RoryFleming/CRT-420-Fleming/README.md

# CRT 420 Fleming
This is a good read. Read: 1/17/18
