RoryFleming/CRT-420-Fleming/Documentation/07 Function Production.pdf

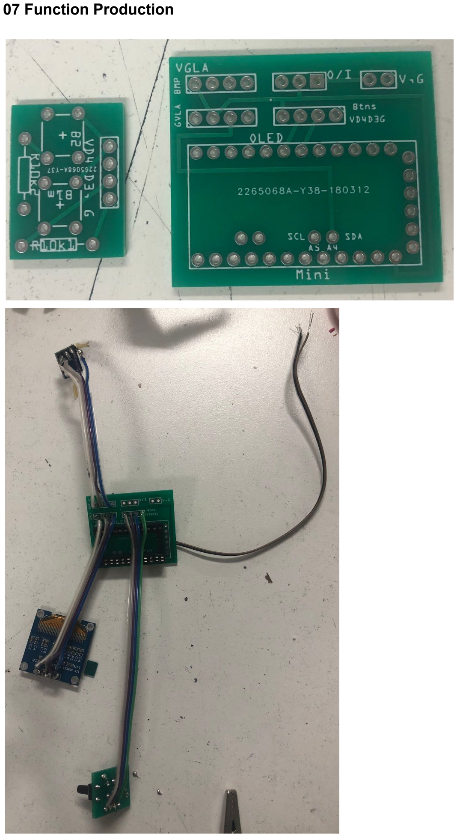
[picture p20: page 1]

### 07 Function Production

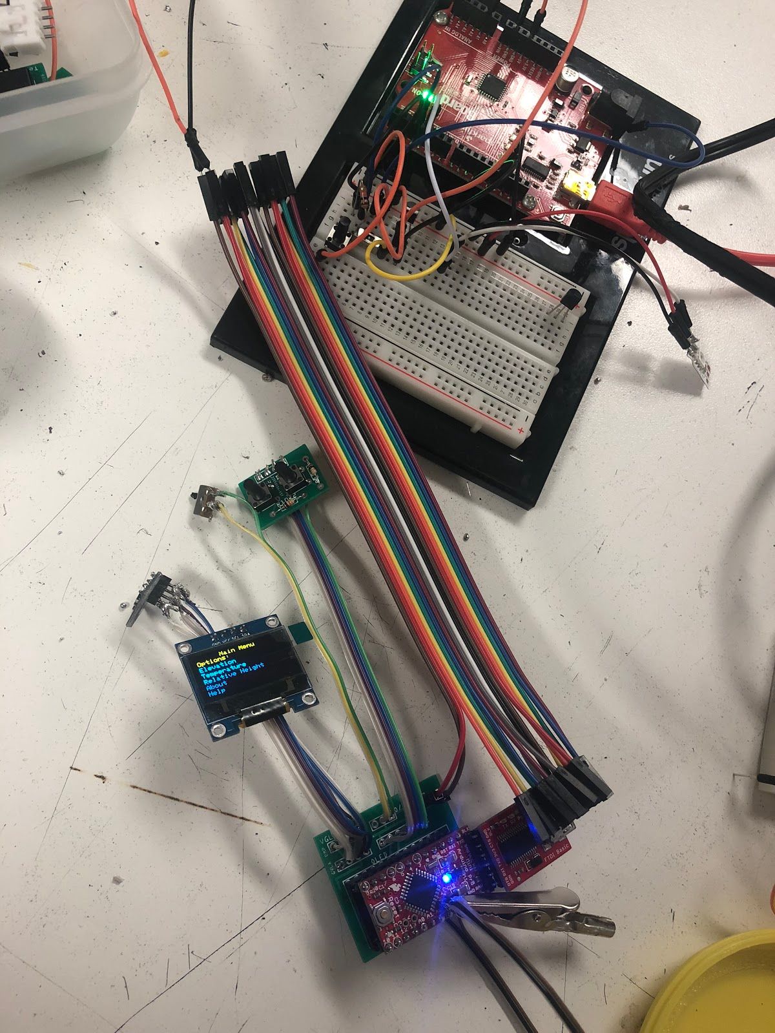
[picture p21: figure]

All parts soldered together and functioning: Buttons, barometer, OLED, O/I switch

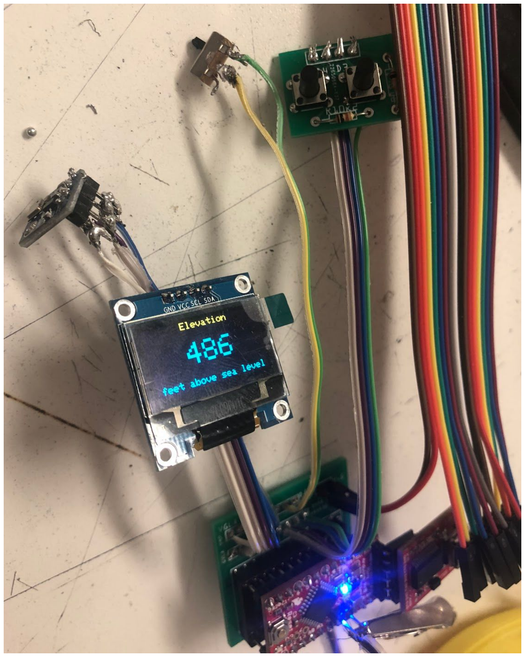
[picture p22: figure]

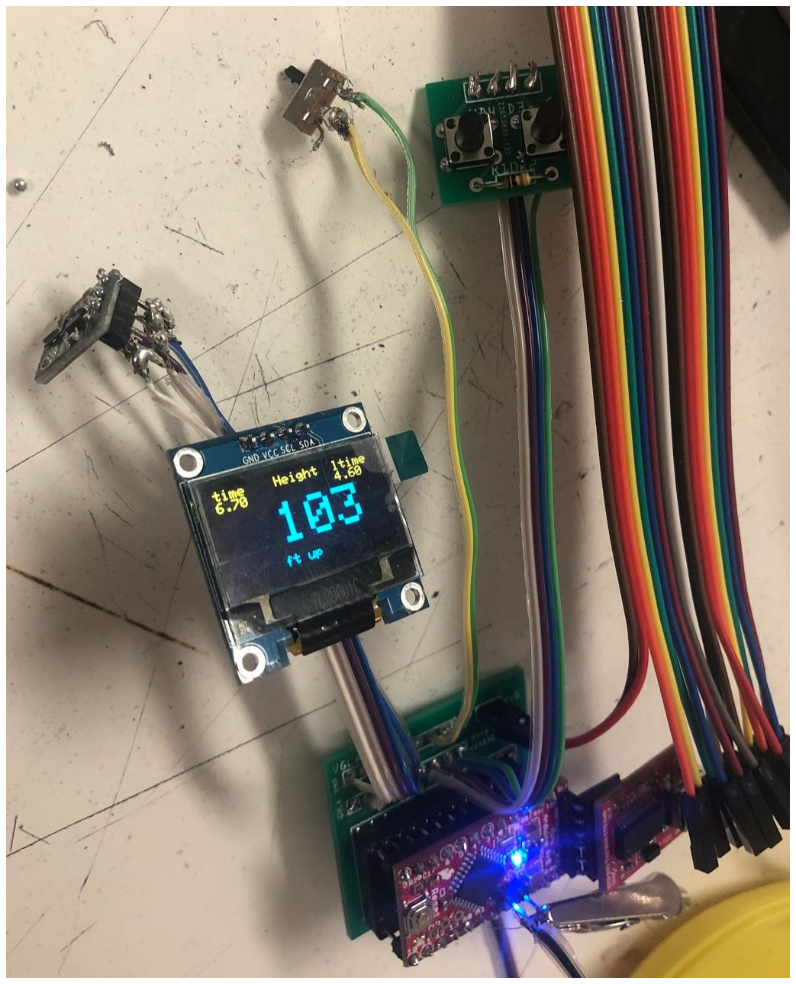
[picture p23: figure]
