RoryFleming/CRT-420-Fleming/Documentation/08 Form Production.pdf

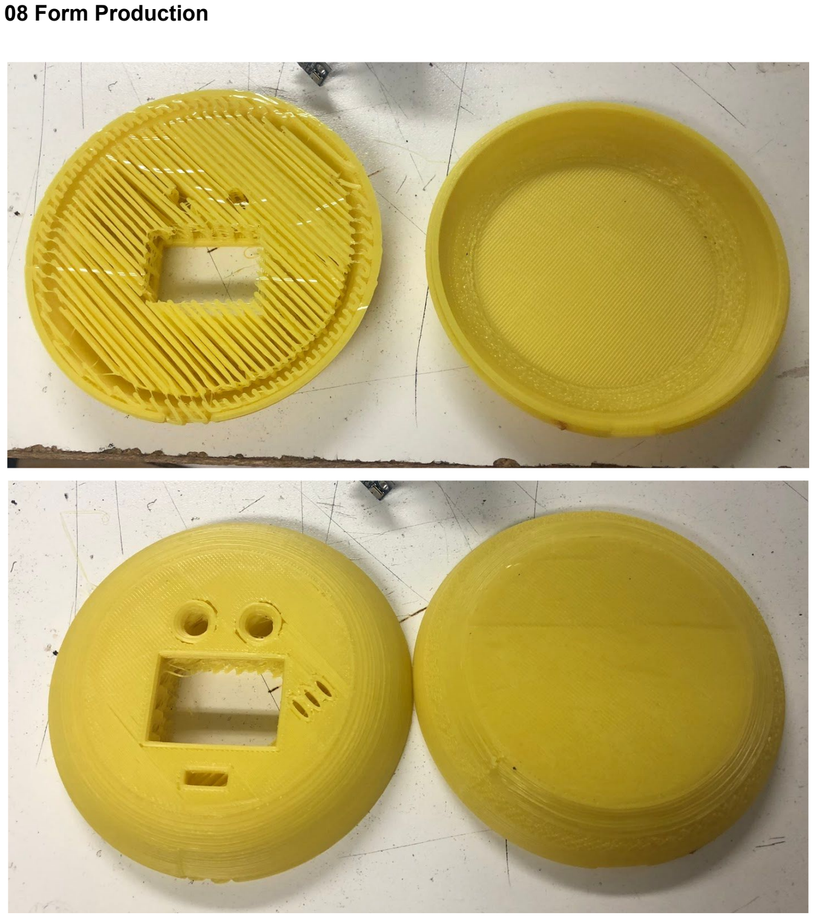
[picture p24: page 1]

### 08 Form Production

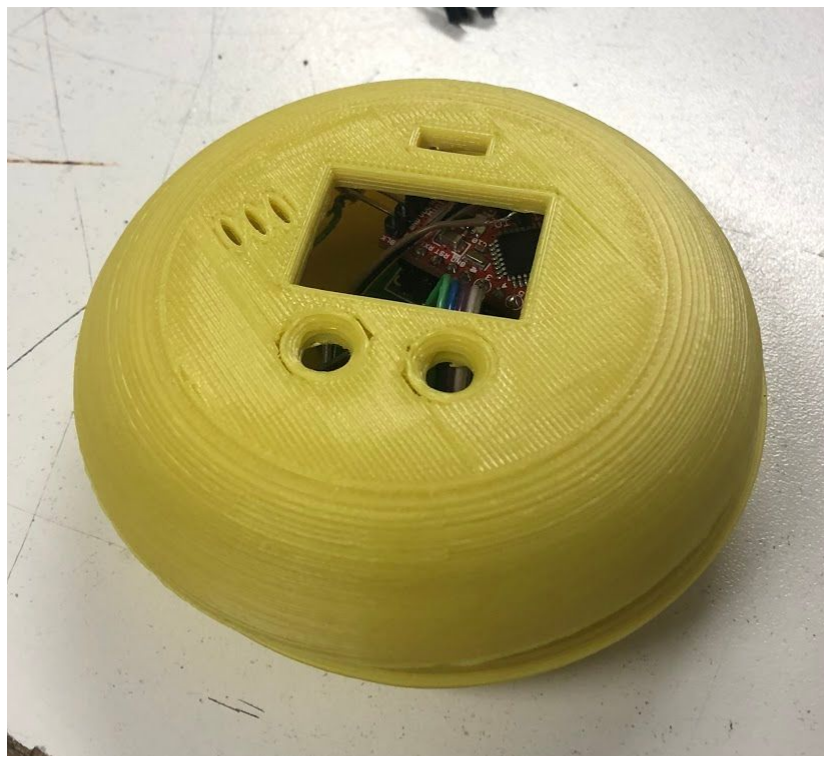
[picture p25: figure]

(Some changes had to be made from here: button holes too far apart for buttons fixed on PCB to fit, O/l switch doesn’t fit through hole, header pins on OLED push against casing too much on inside.)
Some extra printed plastic on top half inner lip prevented complete sealing.

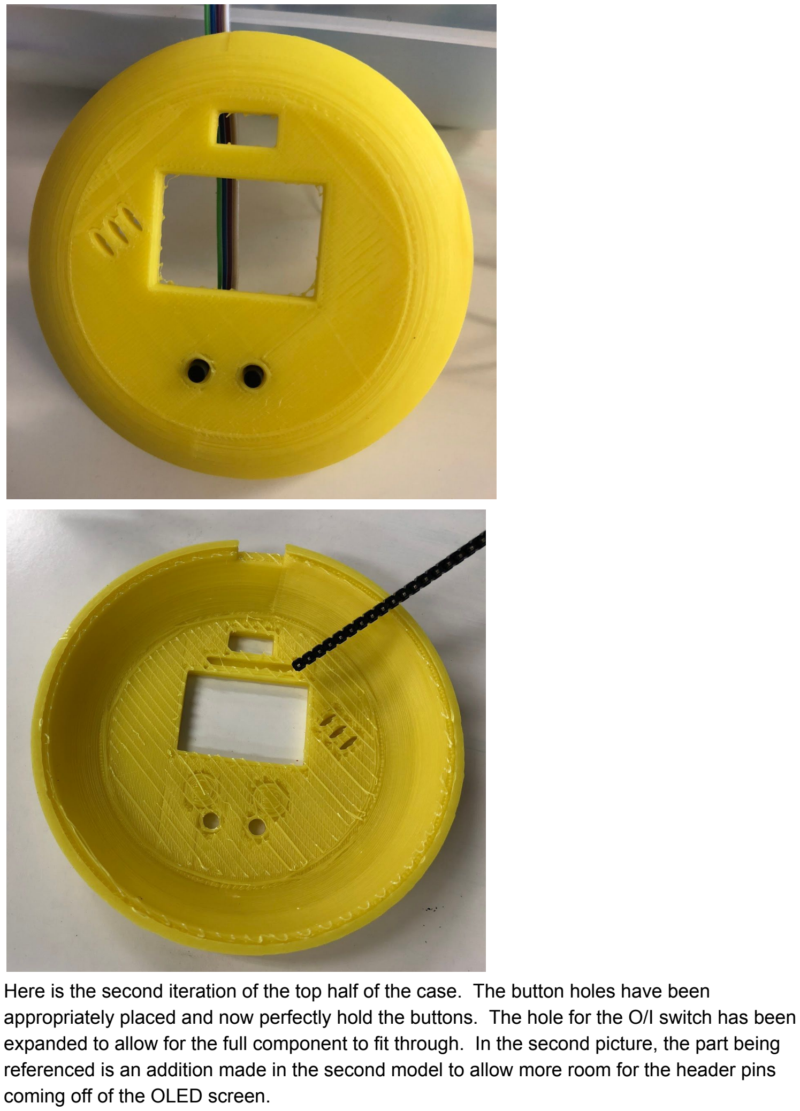
[picture p26: page 3]

Here is the second iteration of the top half of the case. The button holes have been appropriately placed and now perfectly hold the buttons. The hole for the O/I switch has been expanded to allow for the full component to fit through. In the second picture, the part being referenced is an addition made in the second model to allow more room for the header pins coming off of the OLED screen.

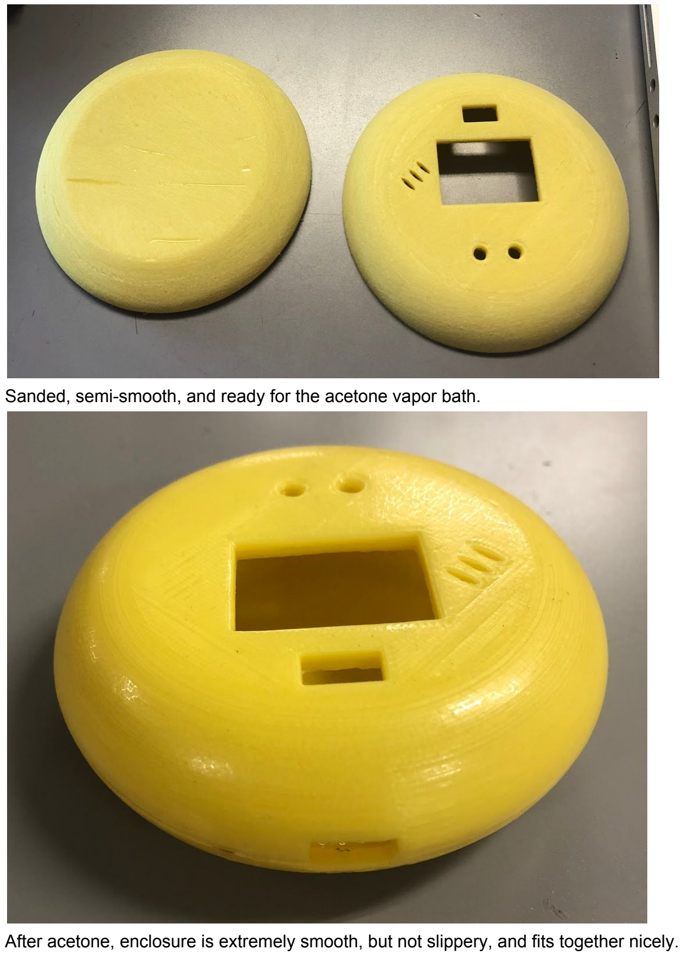
[picture p27: page 4]

Sanded, semi-smooth, and ready for the acetone vapor bath.

After acetone, enclosure is extremely smooth, but not slippery, and fits together nicely.

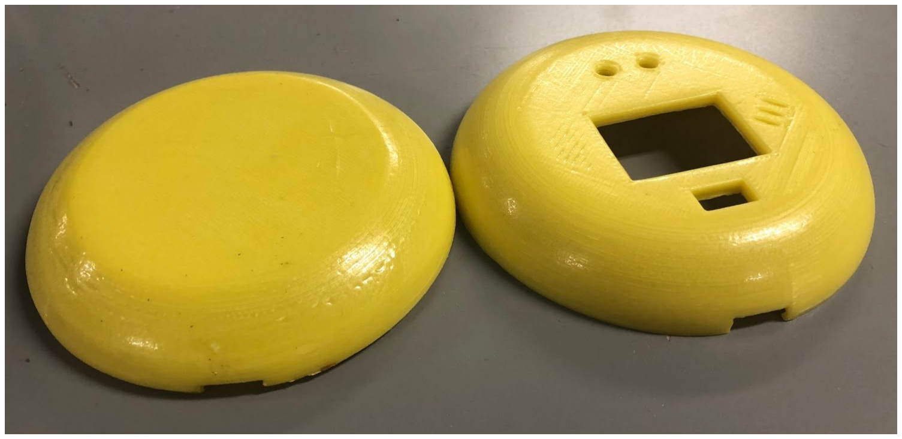
[picture p28: figure]

No extra parts needed for case, although connecting components inside is a different story.
