RoryFleming/CRT-420-Fleming/Documentation/04 Function Development.pdf

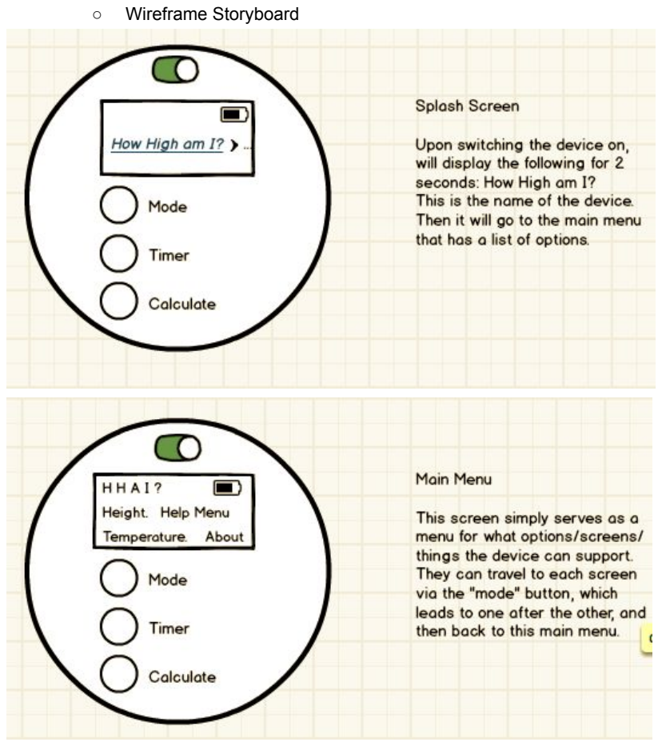
[picture p33: page 1]

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
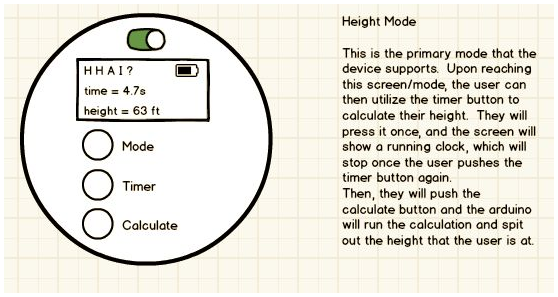
[picture p34: figure]
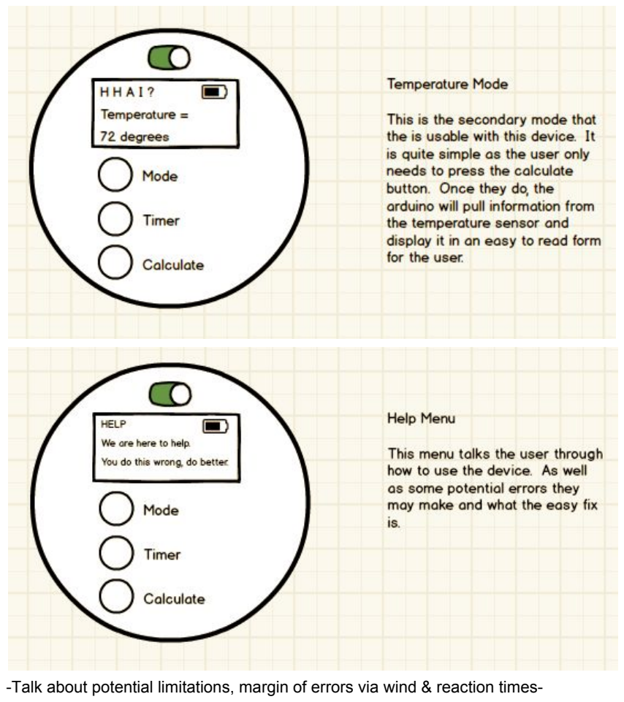
[picture p35: page 3]

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
tial limit

a

tio

n

s, m

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
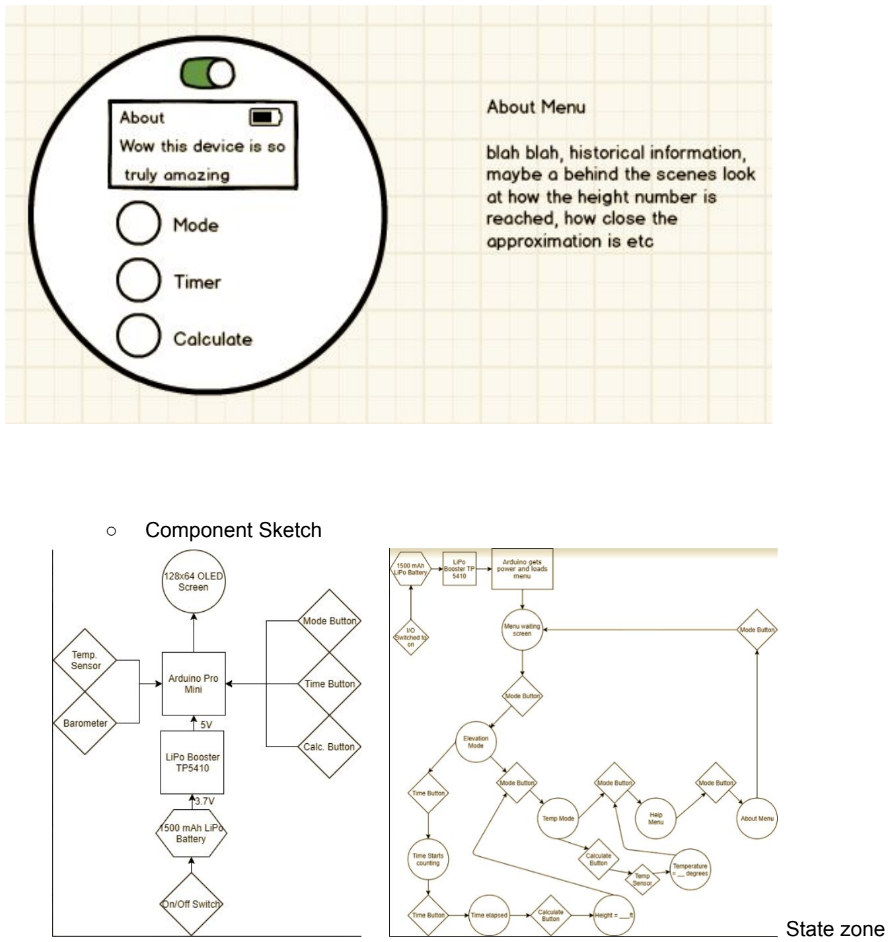
[picture p36: page 4]

- Component Sketch

State zone

- Bill of Materials -
Name | Source | URL | Qty. | Cost
Arduino Pro Mini | AliExpress | https://goo.gl/XTJmMD | 1 | $2.40
OLED Screen 128x64 | Amazon | https://goo.gl/cAiPSX | 1 | $8.99
500 mAh LiPo Bat. | Amazon | https://goo.gl/6sKL4H | 1 | $7.99
LiPo Booster TP5410 | Ebay | https://goo.gl/nNtNMM | 1 | $2.19
10k Ohm Resistor | Lab | | 3 | $2
Push Buttons | Lab | | 3 | $2
Power Slide Switch | Lab | | 1 | $1
Barometer BMP180 | MakerAdvisor | https://goo.gl/riw4MG | 1 | $2

Total cost: $_28.57_
References:

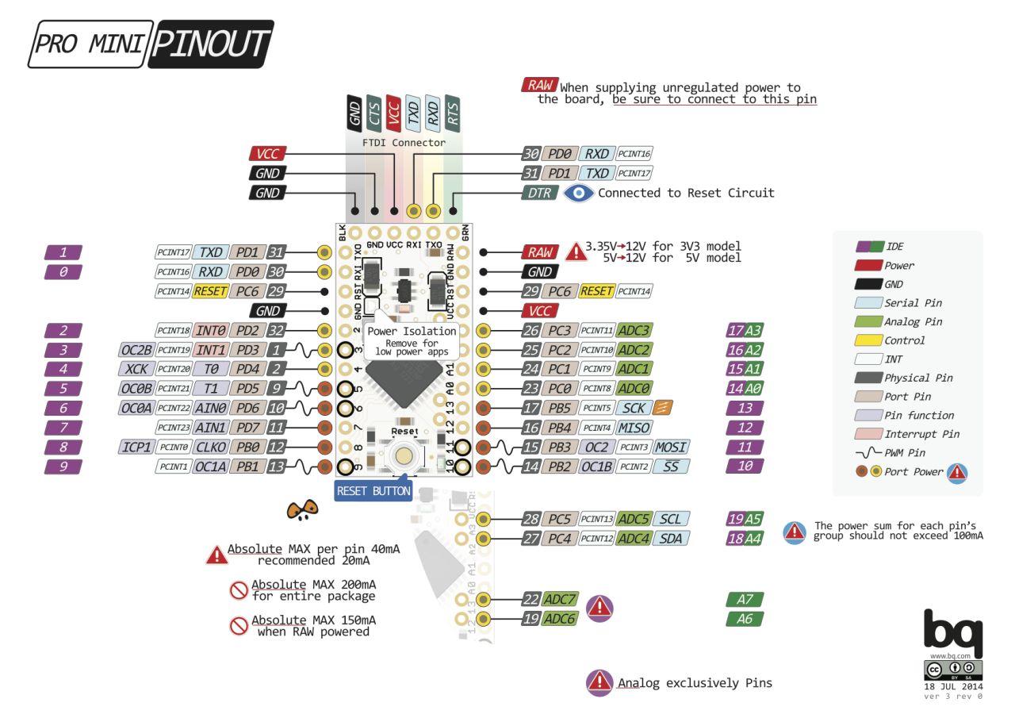
[picture p37: figure]

LED Screen: https://www.youtube.com/watch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 LiPo Battery: https://goo.gl/6sKL4H
LiPo Booster: https://www.youtube.com/watch?v=aND0j2Y2IkM
Buttons: https://learn.sparkfun.com/tutorials/switch-basics
Temp Sensor: https://learn.adafruit.com/tmp36-temperature-sensor/using-a-temp-sensor Barometer: https://learn.sparkfun.com/tutorials/bmp180-barometric-pressure-sensor-hookup-

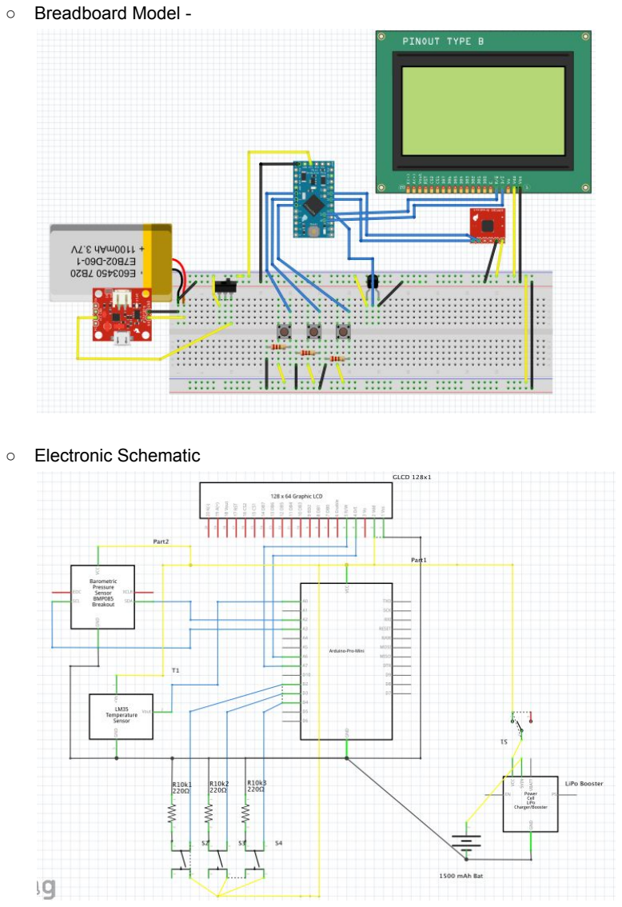
[picture p38: page 6]

- Breadboard Model -
- Electronic Schematic
