RoryFleming/CRT-420-Fleming/Documentation/05 Function Proof.pdf

### 05 Function Proof

Functional Breadboard-

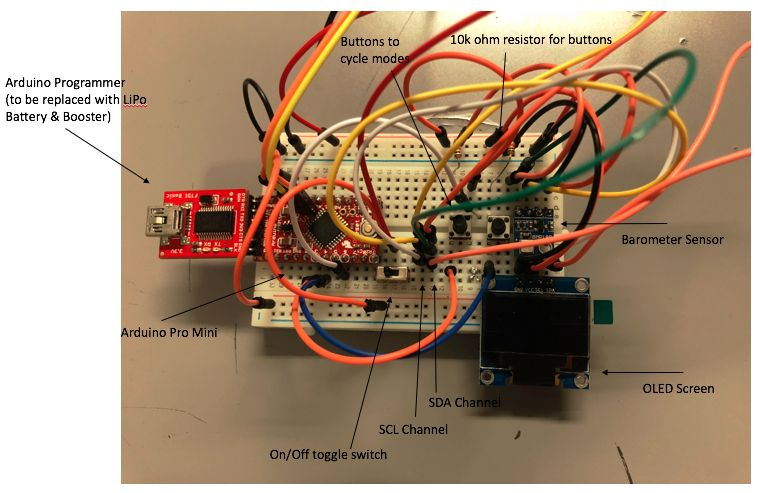
[picture p39: figure]

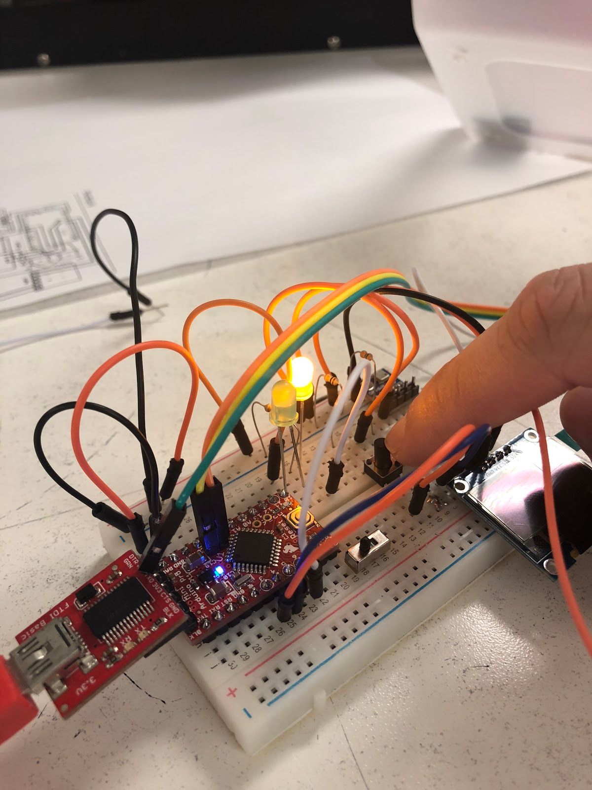
[picture p40: figure]

Buttons work properly. Not pictured: slide switch controlling power correctly

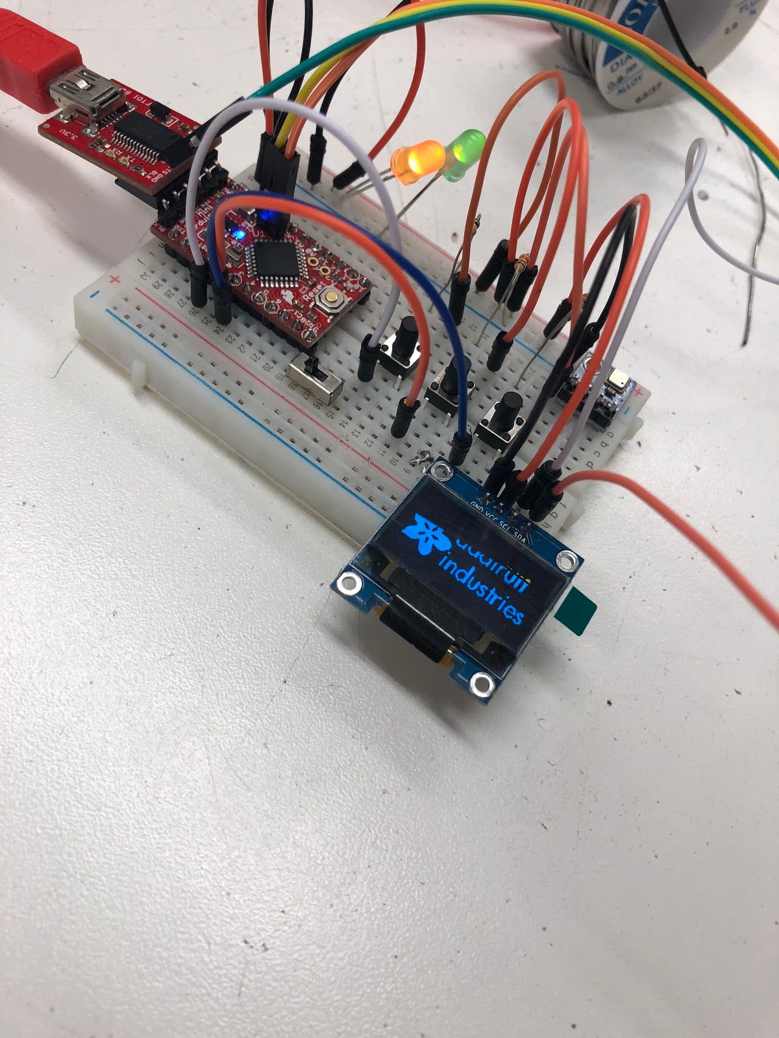
[picture p41: page 3]

Screen loads startup menu

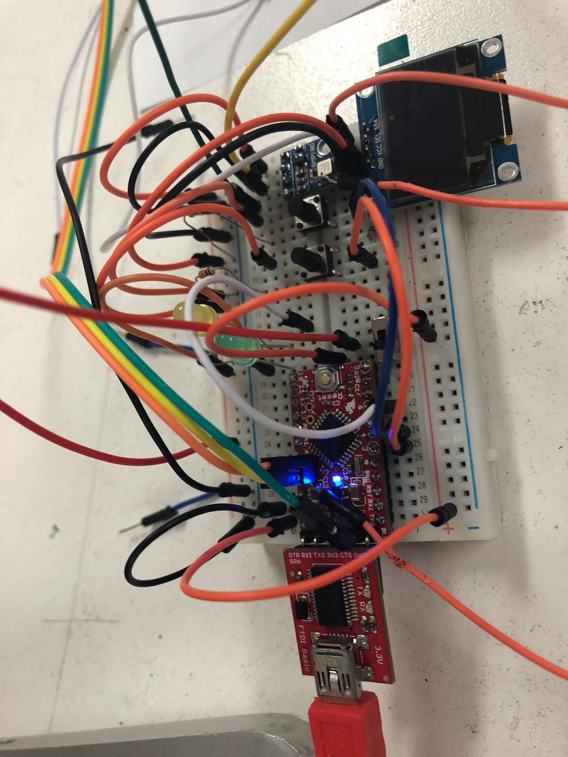
[picture p42: figure]

Barometer is connected to SLC & SDA, rather than the OLED in this photo

Libraries for Barometer:
#include <SFE_BMP180.h>

#include <Wire.h>

Example code for barometer:
File / Examples / Sparkfun BMP180 / SFE_BMP180_example //for BMP180

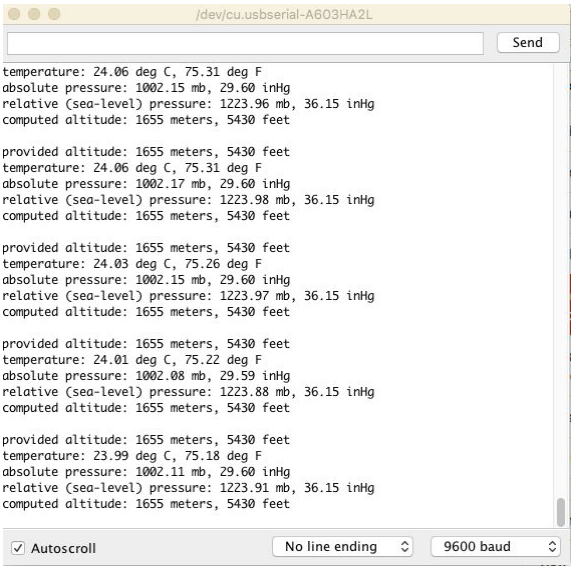
[picture p43: figure]

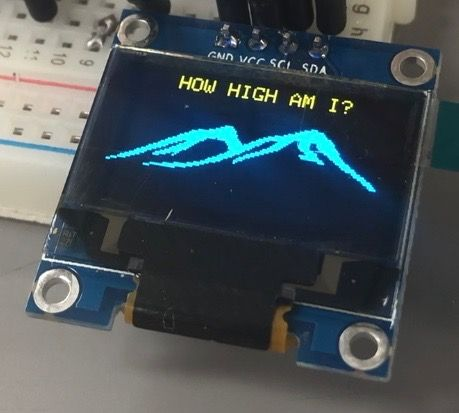
[picture p44: figure]

Splash Screen appears for 3 seconds upon starting program

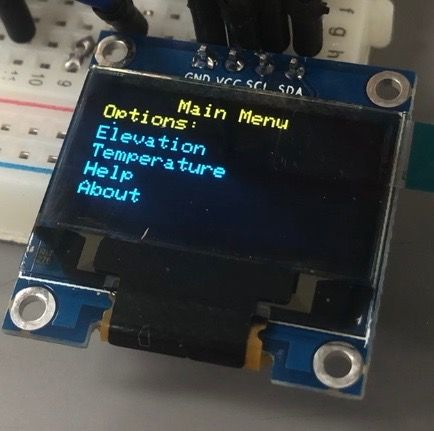
[picture p45: figure]

Main menu showing available options on device, “mode” button cycles through these pages

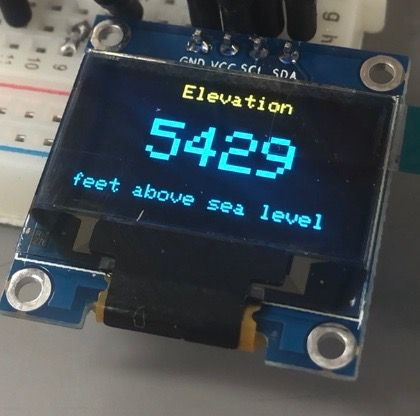
[picture p46: figure]

Showing standard elevation, code based in Colorado

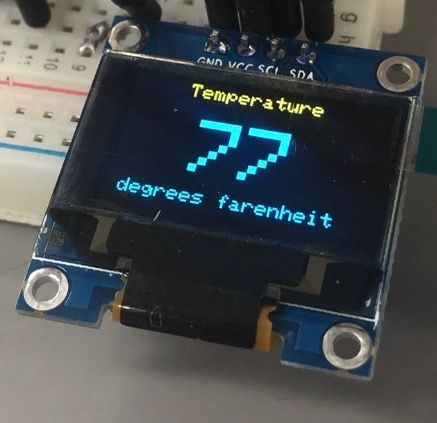
[picture p47: figure]

Elevation and temperature both functioning & drawing from barometer properly

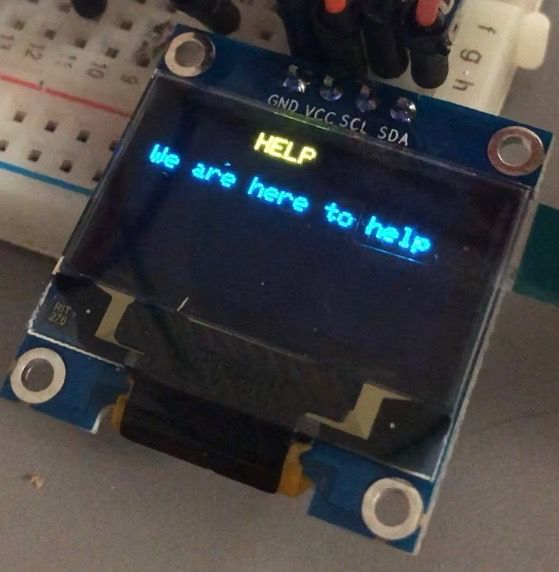
[picture p48: figure]

Help Screen

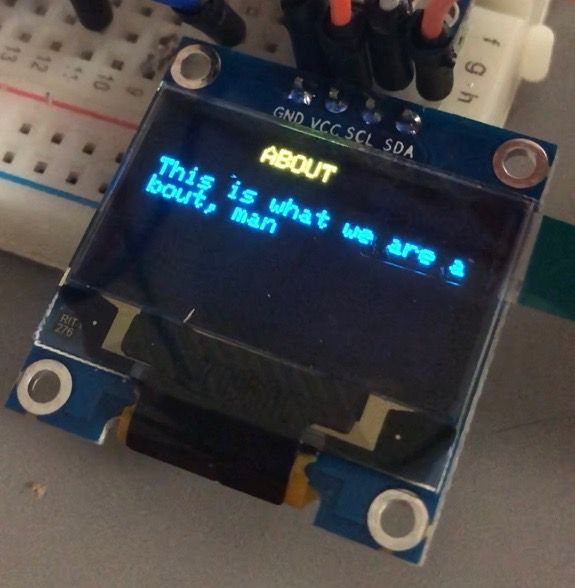
[picture p49: figure]

Initial About page

LED Screen: https://www.youtube.com/watch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 LiPo Booster: https://www.youtube.com/watch?v=aND0j2Y2IkM
Buttons: https://learn.sparkfun.com/tutorials/switch-basics
Barometer: https://learn.sparkfun.com/tutorials/bmp180-barometric-pressure-sensor-hookup-

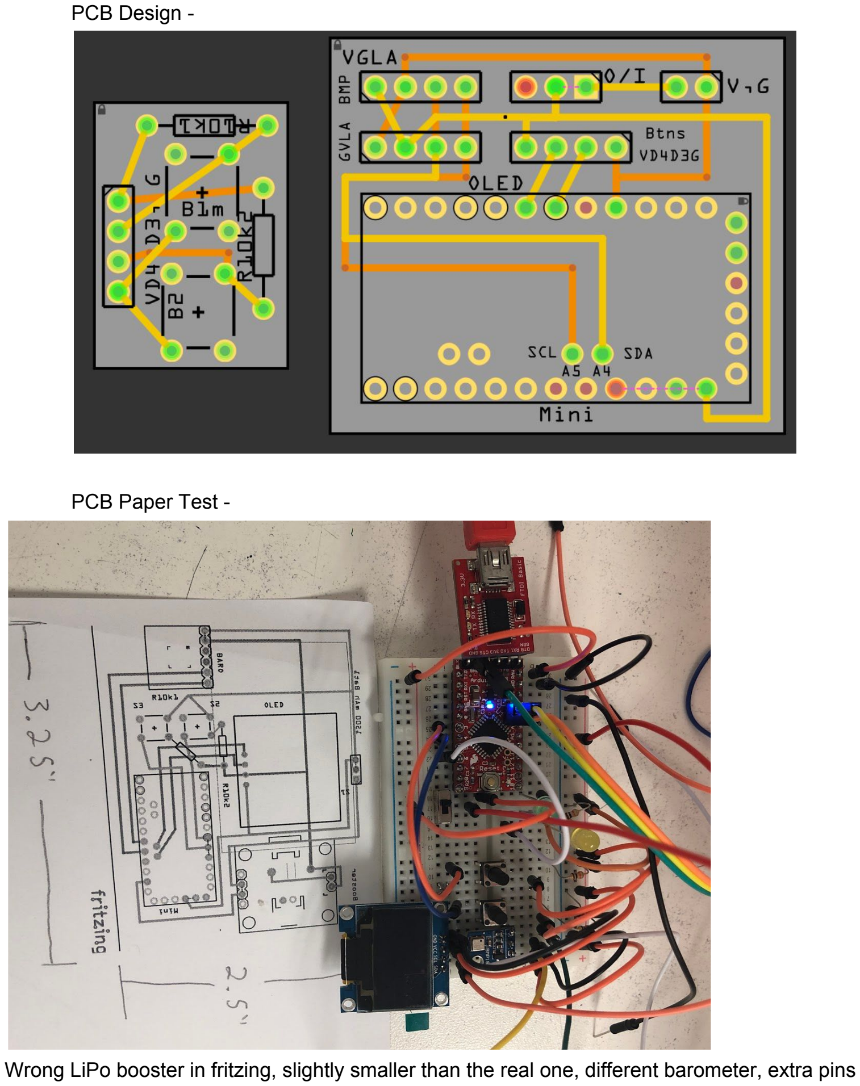
[picture p50: page 12]

PCB Design -

PCB Paper Test -

Wrong LiPo booster in fritzing, slightly smaller than the real one, different barometer, extra pins
