RoryFleming/CRT-420-Fleming/(threads)

Thread 2 (2018-01-27):

01 Feedback

zanecochran, 2018-01-27:
I liked the overall description of the problem space and it sounds like a fun project. I would have liked to have seen an additional inspiration from some sort of altitude sensing device.

RoryFleming, 2018-03-10:
Altitude has been successfully implemented through the use of the BMP Barometer sensor

Closed 2018-03-10.

Thread 4 (2018-02-07):

03 Feedback

zanecochran, 2018-02-07:
Input - You need to be more specific about which buttons/switches you plan on using and what specific functions they will serve.
Power - Which LiPo battery are you planning on using?

RoryFleming, 2018-03-10:
https://goo.gl/6sKL4H : LiPo 500 mAh, successfully changed in 04 func dev

Closed 2018-03-10.
