RoryFleming/CRT-420-Fleming/(list of files, drawings)

Other design files:
PCB/flem 420 pcb brief2.fzz
