RoryFleming/CRT-420-Fleming/(commit log)

2018-03-08 PCB
    uploaded PCB (hopefully)
    [flem 420 pcb brief2.fzz]
2018-03-10 04 update
    updated battery, costs, URLs shortened
